trasukg/aprs-pi/APRSController/APRSController.kicad_pcb

## KiCad design APRSController/APRSController.kicad_pcb (2018-01-31)

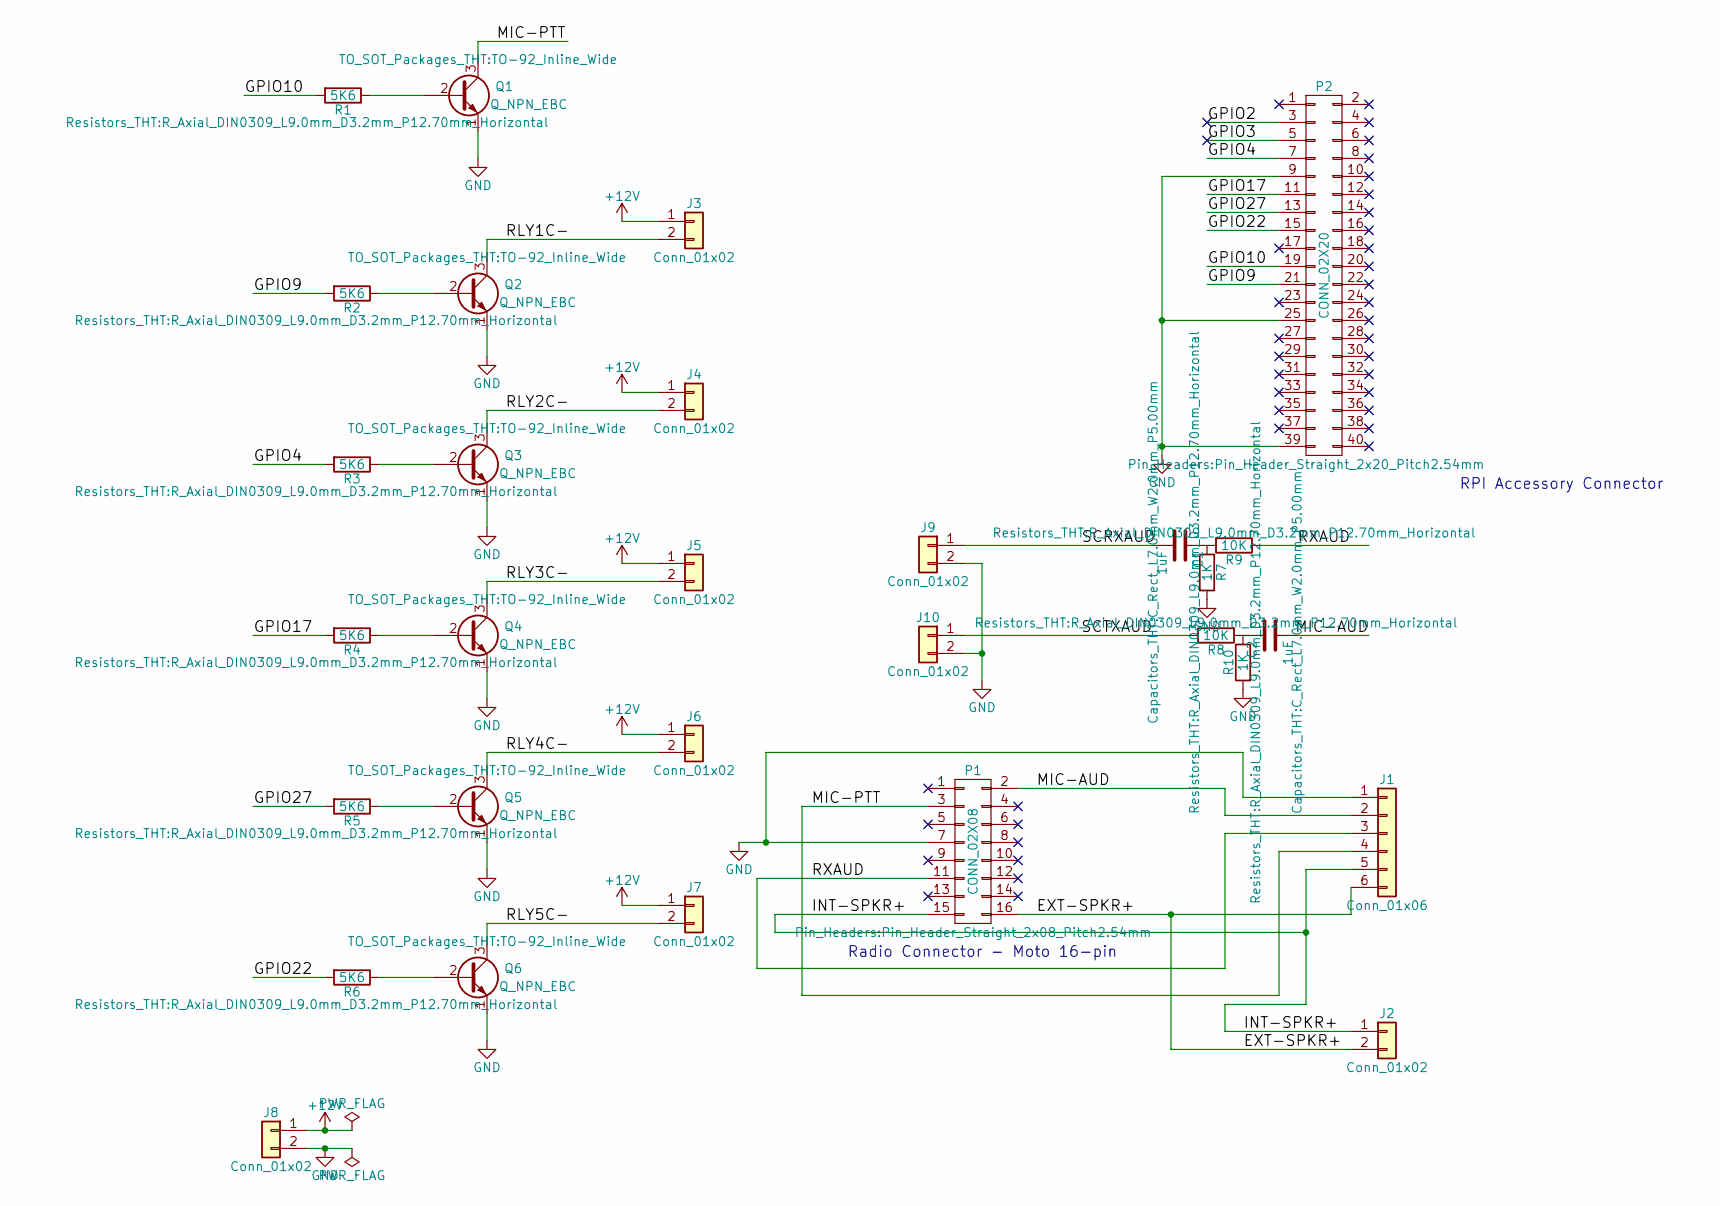
[picture p1: schematic APRSController.sch, APRS Controller Interface]

Parts:
C1, C2: 1uF; C_Rect_L7.0mm_W2.0mm_P5.00mm
J1: Conn_01x06; Molex_KK-6410-06_06x2.54mm_Straight
J2, J3, J4, J5, J6, J7, J8, J9, J10: Conn_01x02; Molex_KK-6410-02_02x2.54mm_Straight
P1: CONN_02X08; Pin_Header_Straight_2x08_Pitch2.54mm
P2: CONN_02X20; Pin_Header_Straight_2x20_Pitch2.54mm
Q1, Q2, Q3, Q4, Q5, Q6: Q_NPN_EBC; TO-92_Inline_Wide
R1, R2, R3, R4, R5, R6: 5K6; R_Axial_DIN0309_L9.0mm_D3.2mm_P12.70mm_Horizontal
R7, R10: 1K; R_Axial_DIN0309_L9.0mm_D3.2mm_P12.70mm_Horizontal
R8, R9: 10K; R_Axial_DIN0309_L9.0mm_D3.2mm_P12.70mm_Horizontal

Connections:
+12V: J3.1, J4.1, J5.1, J6.1, J7.1, J8.1
/EXT-SPKR+: J1.6, J2.2, P1.16
/GPIO2: P2.3
/GPIO3: P2.5
/GPIO4: P2.7, R3.2
/GPIO9: P2.21, R2.2
/GPIO10: P2.19, R1.2
/GPIO17: P2.11, R4.2
/GPIO22: P2.15, R6.2
/GPIO27: P2.13, R5.2
/INT-SPKR+: J1.5, J2.1, P1.15
/MIC-AUD: C2.2, J1.2, P1.2
/MIC-PTT: J1.4, P1.3, Q1.3 (C)
/RLY1C-: J3.2, Q2.3 (C)
/RLY2C-: J4.2, Q3.3 (C)
/RLY3C-: J5.2, Q4.3 (C)
/RLY4C-: J6.2, Q5.3 (C)
/RLY5C-: J7.2, Q6.3 (C)
/RXAUD: J1.3, P1.11, R9.1
/SCRXAUD: C1.2, J9.1
/SCTXAUD: J10.1, R8.1
GND: J1.1, J8.2, J9.2, J10.2, P1.7, P2.9, P2.25, P2.39, Q1.1 (E), Q2.1 (E), Q3.1 (E), Q4.1 (E), Q5.1 (E), Q6.1 (E), R7.2, R10.2
unnamed: C1.1, R7.1, R9.2
unnamed: C2.1, R8.2, R10.1
unnamed: Q1.2 (B), R1.1
unnamed: Q2.2 (B), R2.1
unnamed: Q3.2 (B), R3.1
unnamed: Q4.2 (B), R4.1
unnamed: Q5.2 (B), R5.1
unnamed: Q6.2 (B), R6.1

Notes on the sheet:
Radio Connector - Moto 16-pin
RPI Accessory Connector

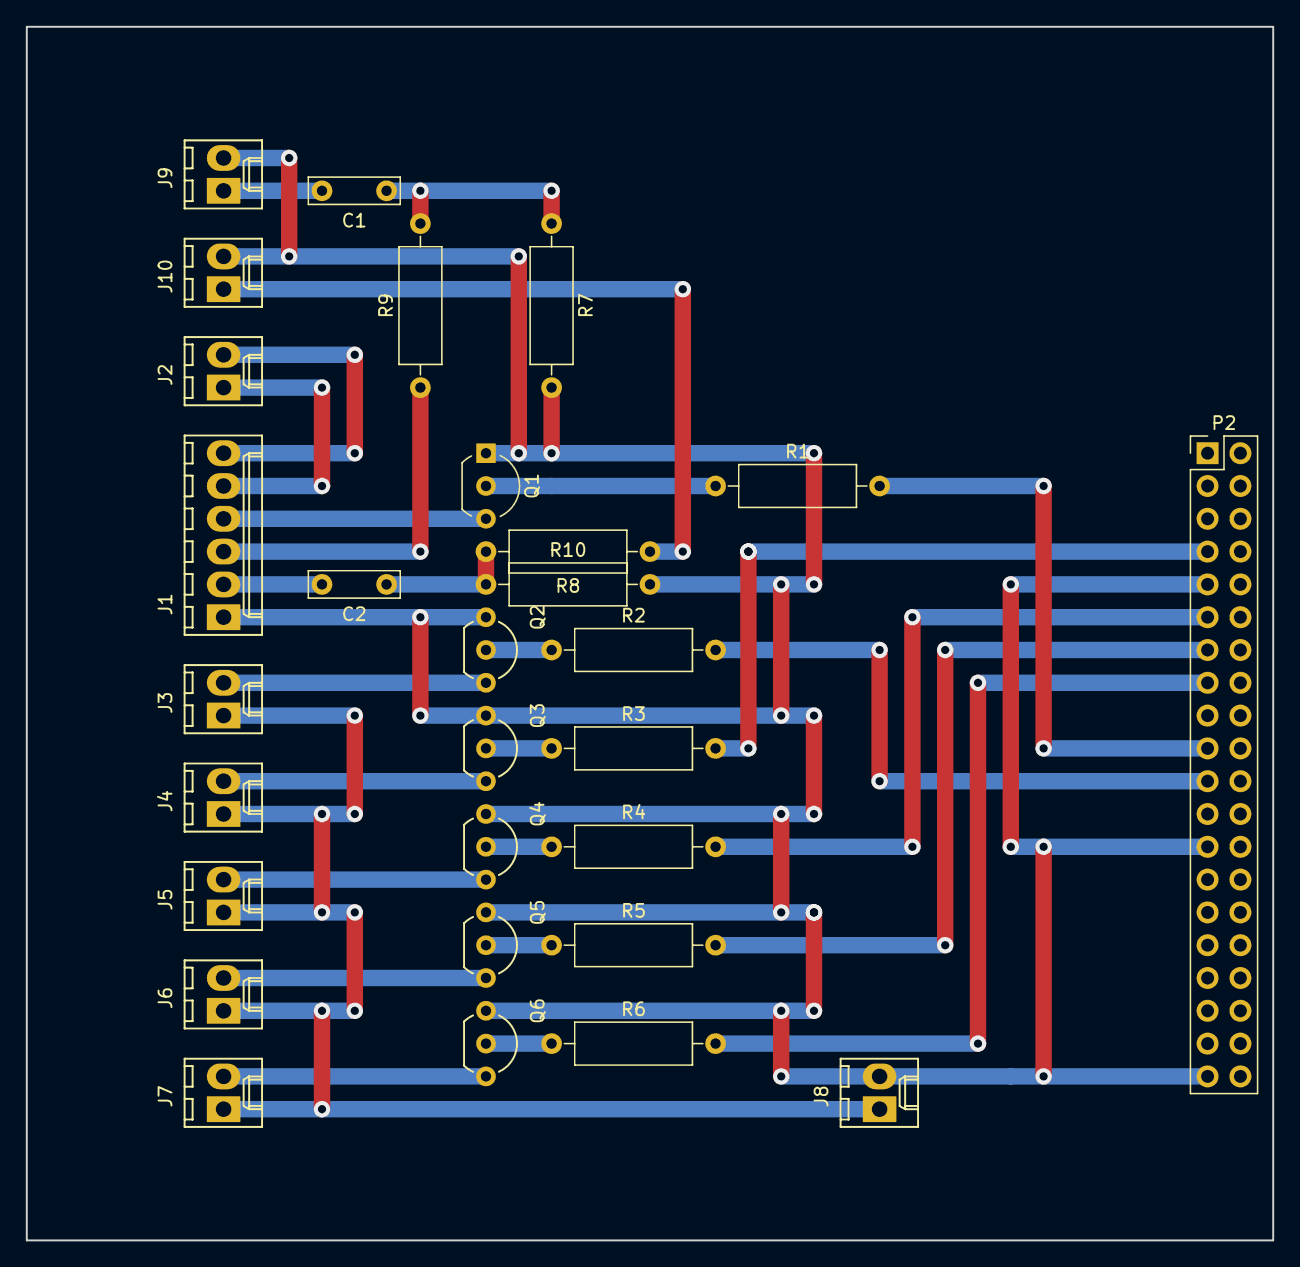
[picture p2: board APRSController.kicad_pcb from above]

Board: 2 copper layers, 96.5 x 94.0 mm, 29 parts (0 on the bottom side), 28 nets.
