trasukg/aprs-pi/(commit log)

2018-01-14 First commit.
    [APRSController.kicad_pcb, APRSController.sch]
2018-01-21 Initial pass at test and calibration programs.
2018-01-31 Changed ptt gpio to be GPIO10, as per revised circuit design.
2018-01-31 Changed controller circuit so as to avoid the I2C lines on the Pi. PTT is now GPIO10. First output is now GPIO9.
    Added two-tone calibration audio to manual test package.
    [APRSController.kicad_pcb, APRSController.sch]
2018-01-31 Make the calibration audio stereo.
